Symplectomorphism/bioreactor/README.md

# ISS-Bioreactor
Some of the code for Boise State's ISS-bioreactor project.
