Symplectomorphism/bioreactor/resources/resources.md

[Teensy-SineWaveGenerator](https://github.com/jameskeaveney/Teensy-SineWaveGenerator)  
[Adafruit-SineWave](https://github.com/adafruit/Adafruit_MCP4725)
