Symplectomorphism/bioreactor/TeX/root.pdf

### Design of the Signal Generator for ISS-Bioreactor

Aykut C. Satici∗
Boise State University
Mechanical and Biomedical Engineering (Dated: April 17, 2023)
This technical report is prepared to document the design of the signal generator circuit for the ISS-Bioreactor project at Boise State University.

### 1. INTRODUCTION

We design an input PWM filter to create the desired 0−10V sine wave at 90Hz that the controller expects from a carrier PWM signal at a carrier frequency 36.6kHz. This technical report builds the final design up over a few major steps. For the impatient reader, the theoretical analysis, the implementation, and the full blown-up schematic of the final design are provided in Section 2.3, Section 3, and Figure 9 of the Appendix A, respectively.

### 2. THEORETICAL ANALYSIS

We perform a basic PWM filter design to generate the driving 0−10V sine wave signal to be fed into the Physik Instrumente (PI)’s controller for one of their piezoelectric actuators [2].

### 2.1. Basic Lowpass Filter Design

Consider the first-order filter sketched in Figure 1 with a sinusoidal driving voltage. The current i over the capacitor is i = C
dvo
dt

. KVL around the loop gives

RC dvo
dt

+ vo = vsig = A cos (ωt)
This differential equation has the transfer function

G(s) = 1 RCs + 1
The steady-state solution of the differential equation is obtained as

vo(t) = A |G(jω)| cos (ωt + ∠G(jω))

=

A
√
1 + ω²R²C² | cos (ωt − arctan (ωRC))
Since we do not want our signal to be attenuated by the low-pass filter, we must choose the values of R and C such that ωRC 1 or 2πRC 1/f.
Unfortunately, our actual input from the microcontroller is not a pure sine wave, rather a PWM signal. Therefore, we also need the value of 2πRC to be large so that it attenuates the high frequencies present in the

∗Electronic address: aykutsatici@boisestate.edu

vsig

R

C

vo

FIG. 1: A first-order low-pass filter circuit.

PWM signal. This requirement is difficult to achieve with just a first-order low-pass filter, leading us to design a second-order low-pass filter in the next subsections.

### 2.2. Second-Order LPF Design

A second-order filter is implemented as a linear operator from the Teensy-generated PWM voltage input vt to the voltage vi

, as presented in Figure 2. The remainder of this circuit constitutes a noninverting op-amp that amplifies the sine wave extracted from its PWM modulation from 0 − 3.3V to 0 − 10V. We analyze the circuit so as to figure out the values of the various resistances

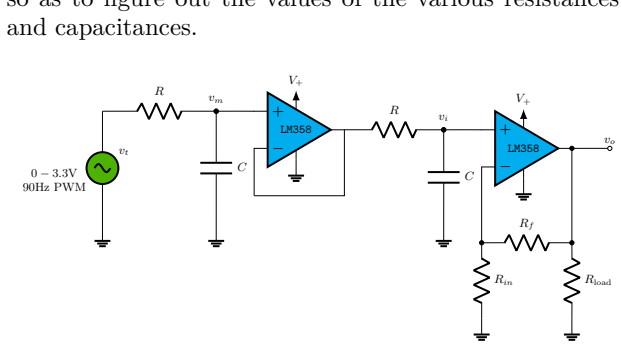
[picture p1: figure]
and capacitances.; 0 − 3.3V 90Hz PWM; Rin; Rload

FIG. 2: The signal generator circuit.

The 0−3.3V PWM signal is to be filtered to extract the modulated sine wave. Thanks to the buffer op-amp, the transfer function from the Teensy input vt to the input vi to the non-inverting amplifier op-amp is given by

H(s) = Vi(s)
Vt(s)

=

1
R²C²s

2 + 2RCs + 1

This is a critically-damped transfer function with both poles at s1,2 = −¹/RC. In other words, the cut-off frequency of this filter is at fn =
1

2πRC with a roll-off of
40dB per decade. Contrast this to the first-order filter of the previous subsection where the roll-off was 20dB per decade. The greater roll-off rate allows us be able to select 2πRC 1/f while simultaneously achieving excellent high-frequency attenuation.
Our desired signal is a 90Hz sinusoidal, which should not be attenuated by the low-pass filter, i.e., the transfer function H(s) should have approximately a unity gain at this frequency. To that end, we set fn = 5×90 = 450Hz, which produces the constraint RC ≤ 1/2πfn.
The attenuation needed at the PWM carrier frequency fc = 36.6kHz provides us with a lower bound on the product RC. If we want no less than α-fold attenuation, then we must have that

−20 log α ≥ 20 log |H(j2πfc)| = −20 log (1 + 4π

2R

2C

2
f

2
c

)

⇒ 1 + 4π

2R

2C

2
f

2
c ≥ α ⇒ RC ≥

√
α − 1
2πfc
We summarize the lower and upper bounds on RC:
√
α − 1
2πfc

≤ RC ≤

1
2πfn
Lastly, we want to amplify the input voltage vi thrice in order to hit the 0 − 10V mark. The gain of the non-inverting amplifier is k = 1 + Rf/Rin. We choose Rf , Rin ≥ 1kΩ so as to achieve k = 3. The high gain bandwidth product of the LM358 op-amp is read from its datasheet to be GBP = 1.2MHz. Hence the transfer function from the input voltage vi to the output voltage vo that will be applied to the PI controller is approximately given by

Vo(s)
Vi(s)

=

k

k
2πGBP s + 1

≈

3
3.979 × 10⁻⁷s + 1

,
which will have a firm unity gain at our desired oscillation frequency of 90Hz.

### 2.3. Sallen-Key Architecture

Another well-known architecture that works well for this sort of problem is the Sallen-Key low-pass filter, which replaces the two RC+buffer combination whose output enters the amplifier op-amp, as shown in Figure 3. The blown-up full schematic of signal generator circuit may be found in Figure 9 of the appendix.
We find the governing equations of this circuit. Assume an ideal op-amp model so that both of the inputs of the op-amp have potential vi

. Let the current i flowing over R1 split into i1 and i2, the former flowing into C1 and the latter into C2 through R2. KCL gives

i = i1 + i2 =

1
R1

(vt − vm),

i1 = C1

d(vm − vi)
dt

,

i2 = C2

dvi
dt

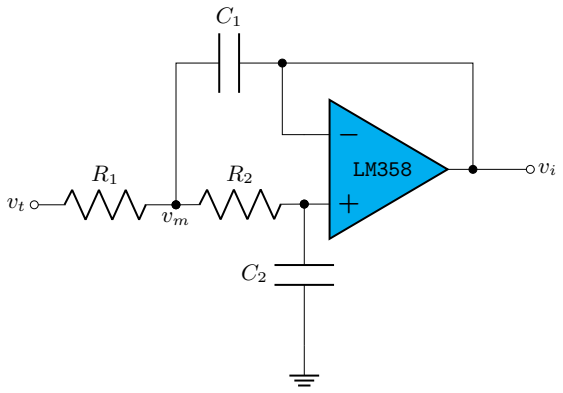
[picture p2: figure]

FIG. 3: Sallen Key (second-order) low-pass filter.

KVL around the bottom loop (vm −vi −gnd) gives vm =
R2i2 + vi = R2C2

dvi
dt + vi

. Plugging this into the second equation gives i1 = R2C1C2
d

2
vi
dt

2 . Combined with the
first and third equations, this yields

R1R2C1C2vï + (R1 + R2)C2v˙i + vi = vt. (1)
The transfer function of the Sallen-Key filter is read as
T(s) = | 1
R1R2C1C2s

2 + (R1 + R2)C2s + 1

. (2)

The gain and phase of this transfer function may be computed as follows

|T(jω)| =

1
p
1 + R²

1R²

2C²

1C²
2ω⁴

,

∠T(jω) = − arctan

(R1 + R2)C2ω
1 − R1R2C1C2ω²

(3)

We want to make this a Butterworth filter, making its frequency response as flat as possible in the passband. To that end, we identify the characteristic polynomial as

s

2 +

R1 + R2
R1R2C2

s +

1
R1R2C1C2

= s

2 + 2ζωns + ω

2
n

,
with the damping coefficient ζ = 1/
√
2. This requirement
on the damping coefficient translates to the constraint on the circuit elements:

(R1 + R2)

2
2R1R2

=

C1
C2
. | (4)

This Butterworth filter requirement simplifies the gain and phase (3) of the transfer function (2) as

|T(jω)| =

1
p
1 + 1/4(R1 + R2)

4C⁴
2ω⁴

,

∠T(jω) = − arctan

2(R1 + R2)C2ω
2 − (R1 + R2)

2C²
2ω²

(5)

We ask that the magnitude of the output signal to be very close to the input signal, i.e., 1/α1 |vt(t)| ≤ |vi(t)| ≤ |vt(t)| at the frequency of operation fo (e.g. 90Hz), where α1 > 1 and α1 ≈ 1 (e.g. α1 = 1 + 1/1000).
q
1 + 1/4(R1 + R2)

4C⁴
2

(2πfo)

4 ≤ α1,
or solving for the circuit elements

(R1 + R2)C2 ≤

p4 α
2
1 − 1
√
2πfo
. | (6)

Asking for no less than α2-fold attenuation (α2 1) at the PWM carrier frequency fc provides the constraint
q
1 + 1/4(R1 + R2)

4C⁴
2

(2πfc)

4 ≥ α2,
or, solving for the circuit elements,

(R1 + R2)C2 ≥

p4 α
2
2 − 1
√
2πfc
. | (7)

Combining the gain requirements (6) and (7), we obtain the design interval

p4 α
2
2 − 1
√
2πfc

≤ (R1 + R2)C2 ≤

p4 α
2
1 − 1
√
2πfo

. (8)

To find specific values for the resistances and capacitances, we specify the following quantities:
1. Tolerated attenuation at operation frequency: α1,
2. The value of the decoupling capacitance: C2,
3. The ratio between the resistances: r = R1/R2. Once these are specified, the values of the remaining circuit components can be pinpointed. Indeed, from the constraint (4), we obtain that

C1 =

(1 + r)

2
2r

C2.
We make sure that the signal amplitude is attenuated no more than a factor of α1 at the operating frequency as well as provides ample attenuation at the PWM carrier frequency by satisfying the second inequality in (8) as equality. This gives

R2 =

p4 α
2
1 − 1
(1 + r)

√
2πC2

and R1 = rR2.

Remark 1. Choosing the values for the circuit elements in this manner also determines the natural frequency and hence the phase shift. From the Sallen-Key filter transfer function 2, the natural frequency is computed from

fn =

1
2π

√
R1R2C1C2

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
1 − 1.
Further, using equation (5), the phase shift is given by

∠T(j2πf) = − arctan

√
2f/fn
1 − f

/f
n

TABLE I: Theoretical values of resistances and capacitances.

R1 | R2 | C1 | C2 | Rf | Rin

440.8kΩ 88.2kΩ 3.6nF 1nF 2kΩ 1kΩ
We have used this procedure to compute the values for the circuit components, selecting α1 = 1 + 1/1000, C2 = 1nF and r = 5. The values for the remaining components are provided in Table I. This is a Butterworth filter that is maximally flat in its passband with fn = 425.5Hz and provides −77.4dB attenuation at the carrier frequency. At the operation frequency fo = 90Hz, this filter introduces a phase shift of −17.39◦
Remark 2. This is the filter to be implemented in the final design. The experimental values of R1, R2, C1 and C2 are selected to be standard values that are closest to the values provided in Table I.

### 3. RESULTS

We provide extensive simulation and experimental data and their interpretation, supporting that the proposed analog signal generator works as intended.

### 3.1. Simulation

We perform a realistic LTSpice [1] simulation of both second-order filters derived in Sections (2.2, 2.3). One of the important aspects of these designs is the selection of the op-amp. In order to keep the common-mode voltage at 0V we choose the op-amps as CMOS type. One such op-amp is LM358 [4], which is used in the final design, even though a similar op-amp OP292 was used in this simulation.
The PWM signal generated by Teensy [3] is simulated with a carrier frequency of 36.6kHz modulating the signal

Vpwm = 3.3/2 + 3.3/2 sin (2π90t).
Finally, the impedance of the load (PI’s controller) is read off from its datasheet and inserted as a 100kΩ resistance.
3.1.1. RC+Buffer Simulation The simulation for the architecture in Section 2.2 generates the relevant voltage responses, provided in Figure 5. The top plot shows the PWM signal generated by Teensy modulating a sine-wave at 90Hz frequency. The individual plots in the middle show the output of the first (green) and the second (purple) RC low-pass filters (vm and vi

in Figure 2, respectively) that extract the modulated signal from its PWM representation. Finally, the last plot shows the thrice amplified signal through the op-amp OP292. The simulated circuit is provided in Figure 4.

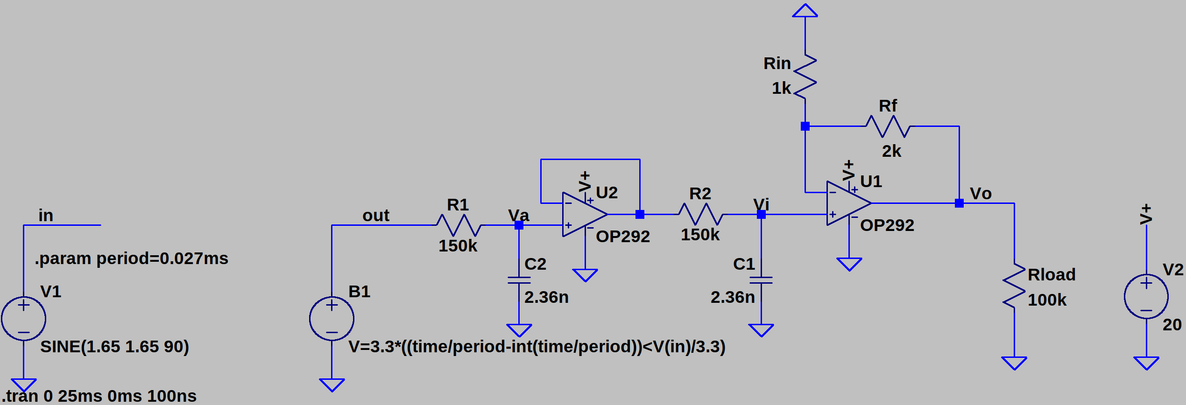
[picture p3: figure]

FIG. 4: The RC+buffer signal generator circuit in LTSpice.

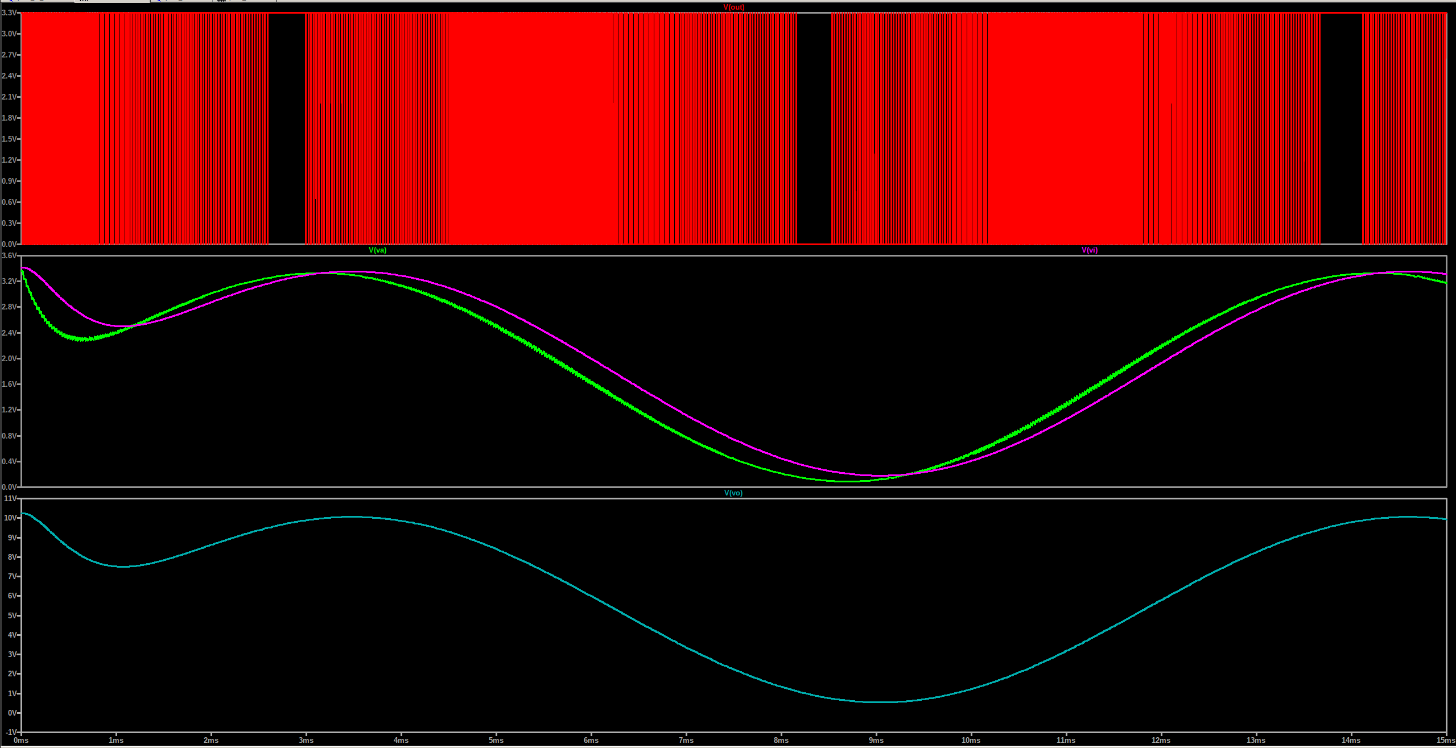
[picture p4: figure]

FIG. 5: The response of the RC+buffer signal generator.

3.1.2. Sallen-Key Simulation The performance of the Sallen-Key architecture from Section 2.3 is shown in Figure 6. The values for the resistances were taken to be R1 = 416.8kΩ, R2 = 83.4kΩ, Rf = 2Rin = 1kΩ and capacitances to be C1 = 3.6nF, C2 = 1nF. The LTSpice circuit diagram for this simulation is provided in Figure 7. Even though the performance of the Sallen-Key filter of Section 2.3 looks very similar to the RC+buffer filter of Secton 2.2 in simulation, the experiments favor the Sallen-Key significantly. We will implement this filter in our final design.

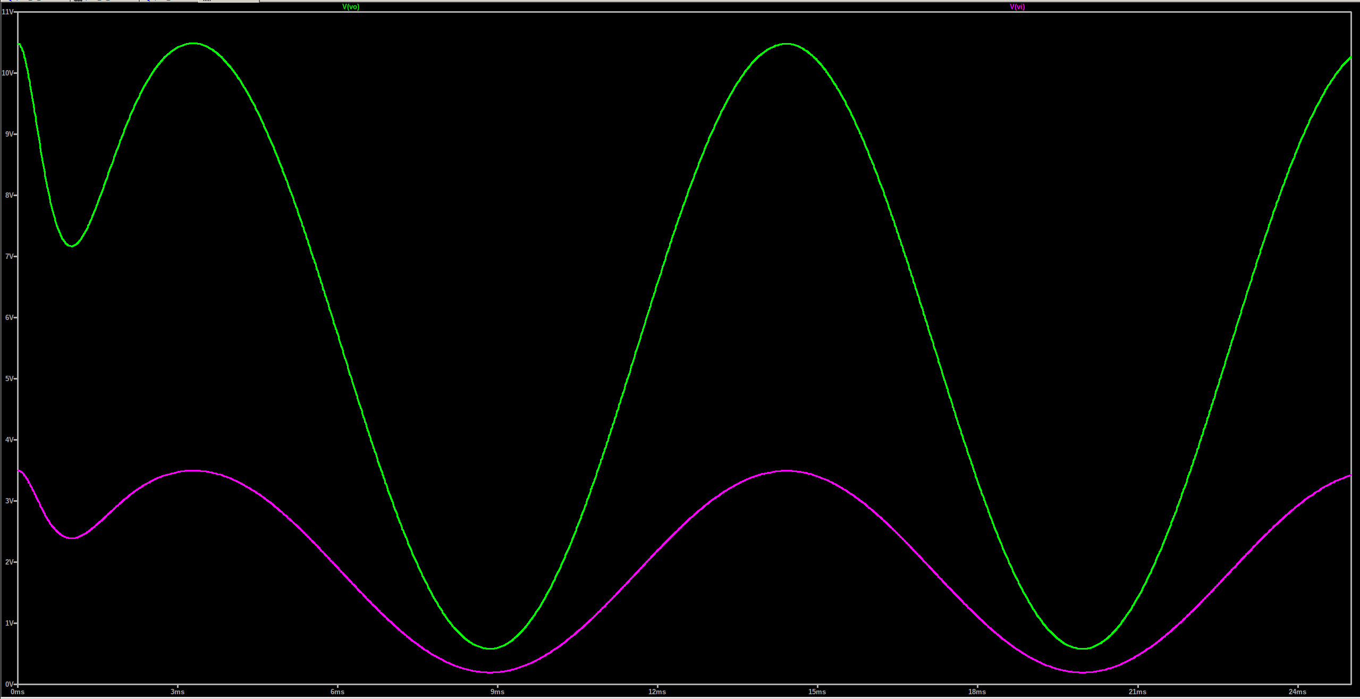
[picture p5: figure]

FIG. 6: The response of the Sallen-Key architecture.

### 3.2. Experiment

The Sallen-Key architecture is implemented on a simple setup on my tabletop. A snapshot of Teensy’s PWM signal that modulates the desired sine-wave output is provided in Figure 8a.

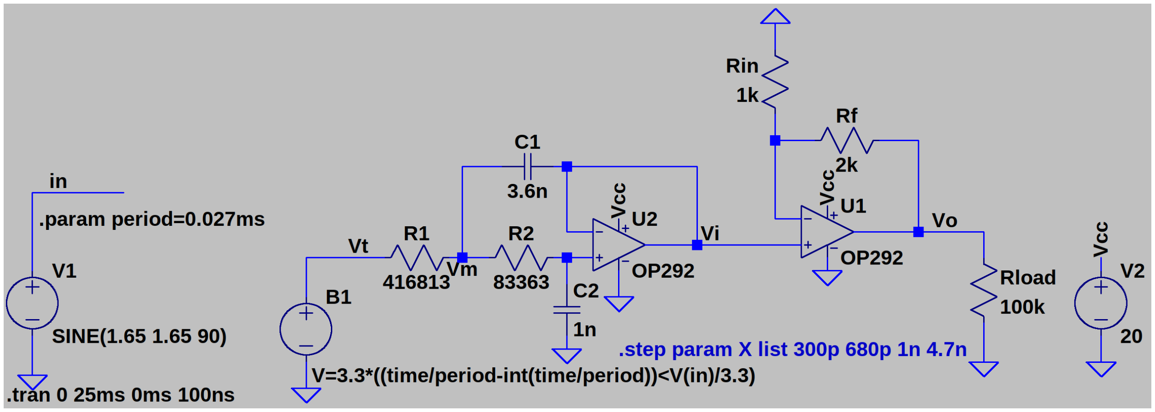
[picture p6: figure]

FIG. 7: The Sallen-Key filter circuit in LTSpice.

Figure 8b shows the response of the second-order Sallen-Key LPF observed through an oscilloscope. This is the output of the signal generator in response to the Teensy generated 90Hz 0−3.3V PWM signal modulating the desired sine wave. This response is satisfactory and should drive the PI controller without any issues.

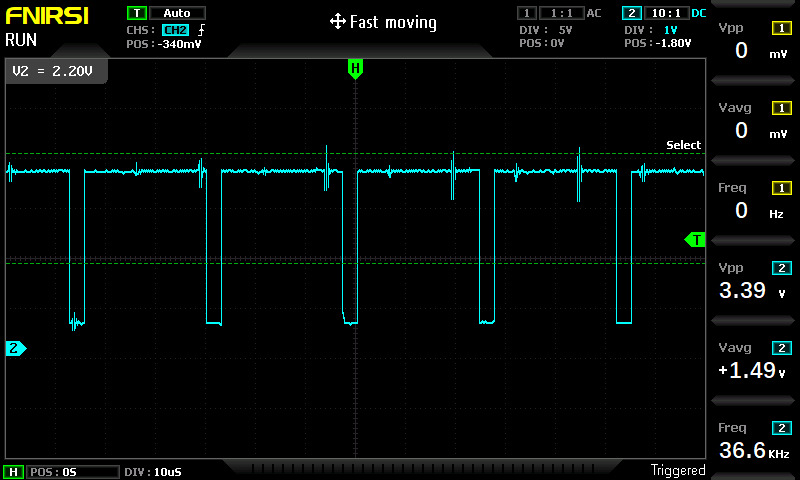
[picture p7: figure]

(a) A snapshot of Teensy’s PWM signal with a carrier frequency of
36.6kHz.

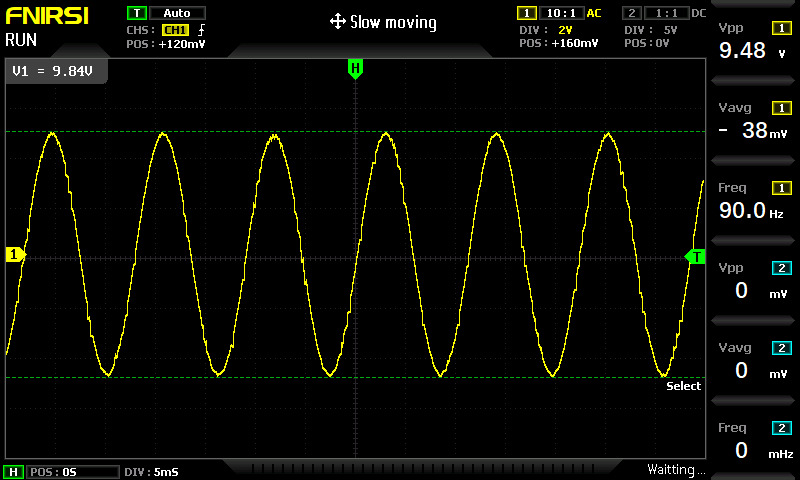
[picture p8: figure]

(b) The response of the second-order Sallen-Key filter. FIG. 8: Experimental verification of the Sallen-Key filter design.

We have also tested the signal generator by driving PI’s piezoelectric actuator. It turns out that since Teensy’s imperfect PWM generation, the best values of the various capacitances and resistances seen in the circuit diagram 9 are as given in Table II. These are the values to be used

TABLE II: Experimental values of resistances and capacitances.

R1 | R2 | C1 | C2 | Rf | Rin

500kΩ 100kΩ 3.20nF 1nF 2kΩ 1kΩ
in the final design.

### 4. DISCUSSION AND CONCLUSIONS

A sine wave is modulated using a 0−3.3V PWM output of a Teensy 4.1 microcontroller at a carrier frequency of 36.6kHz. We presented two second-order lowpass filters to extract the modulated signal from its PWM representation: (i) RC+buffer configuration, (ii) Sallen-Key architecture. We have shown that in simulation both filters perform similarly, however in experiments the Sallen-Key filter performs significantly better. We have decided to use this filter in our final design on the bioreactor.

### 5. ACKNOWLEDGMENT

The author thanks Drs. John Chiasson and Vishal Saxena of Electrical and Computer Engineering at Boise State University and University of Delaware, respectively, for their invaluable insights into the practical implementation of the signal generator.

[1] Analog Devices. | LTSpice. | URL https:
//www.analog.com/en/design-center/ design-tools-and-calculators/ltspice-simulator. html. (https://www.analog.com/en/design-center/design-tools-and-calculators/ltspice-simulator.html)
[2] Physik | Instrumente. | E-610. | URL
https://www.physikinstrumente.com/en/products/controllers-and-drivers/nanopositioning-piezo-controllers/e-610-piezo-amplifier-controller-601000. (https://www.physikinstrumente.com/en/products/controllers-and-drivers/nanopositioning-piezo-controllers/e-610-piezo-amplifier-controller-601000)
[3] PJRC. Teensy. URL https://www.pjrc.com/teensy/.
[4] Texas Instruments. LM358B. URL https://www.ti.com/product/LM358B. (https://www.ti.com/product/LM358B)

Appendix A: Full Circuit Drawing of the Final
| Design
The final signal generator circuit schematic is presented in Figure 9. The potential vt denotes the 0−3.3V PWM signal modulating a 90Hz sinusoidal wave at a carrier frequency of 36.6kHz. The potential vo denotes the 0−10V analog 90Hz sine-wave signal ready to be sent to the Physik Instrumente controller E-610, depicted in the figure as the impedance Rload, as its reference input. The capacitances and the resistances are provided in Table II.

Appendix B: Alternative Filter During testing, I have mistakenly implemented the circuit presented in Figure 10. Later, I analyzed the circuit by figuring out its transfer function. I include this circuit in here just as an academic curiosity. It has no bearing on the ISS mission and should be ignored for that purpose.

### 1. Deriving the equations of the circuit

The voltage divider at the inverting input of the second op-amp gives

vo = (1 + Rf/Rin) vi =: kvi

| | . | (B1)
Let i1 and i2 be the currents that flow over C1 and C2, respectively. KVL around various loops give the following

relationships

vm = R2i2 + vi

, | | (vm − vi − gnd), (B2)

vm = Ri1 + v1 + vi

, | (vm − v1 − vi − gnd), (B3)
vt = R1(i1 + i2) + vm, | | (vt − vm − gnd). (B4)
The constitutive equations for capacitors provide the last two relevant equations
i1 = C1v˙1, | | i2 = C2v˙i .
We want to obtain an input-output relationship between vt and vo.
a. Step 1. Use constitutive equations for the capacitors to reduce equations (B2-B4).

vm = R2C2v˙i + vi = RC1v˙1 + v1 + vi
,
vt = R1C1v˙1 + R1C2v˙i + vm.
b. Step 2. Substitute equation (B2) into equation (B4).

vt = R1C1v˙1 + R1C2v˙i + R2C2v˙i + vi
= R1C1v˙1 + (R1 + R2)C2v˙i + vi .
c. Step 3. Eliminate v1 and v˙1.

RC1vṫ + vt = R1C1 (RC1v¨1 + ˙v1) + (R1 + R2)RC1C2vï+ RC1v˙i + (R1 + R2)C2v˙i + vi
= R1R2C1C2vï + (R1 + R2)RC1C2vï+ (RC1 + (R1 + R2)C2) ˙vi + vi
= (R1R2 + R1R + R2R) C1C2
| | {z | }
| a

vï+

(RC1 + (R1 + R2)C2)
| | {z | }
| b | v˙i + vi

where in the second equality, we used the first equations from Step 1. Combining this with equation (B1) we obtain the final relationship.

avö + bvȯ + vo = k(RC1vṫ + vt). | (B5)

As a transfer function, we have

T(s) = Vo(s)
Vt(s)

= k

RC1s + 1
as² + bs + 1

. (B6)

Note that if R = 0, we recover the original Sallen-Key low-pass filter transfer function (2):

Vo(s)
Vt(s)

=

k
R1R2C1C2s

2 + (R1 + R2)C2s + 1

### 2. Analyzing the circuit

This filter has a zero in the left-half plane at z = −¹/RC1, in contrast to the original Sallen-Key filter. The presence of the resistance R is almost always parasitic and does not help with the desired signal generation.

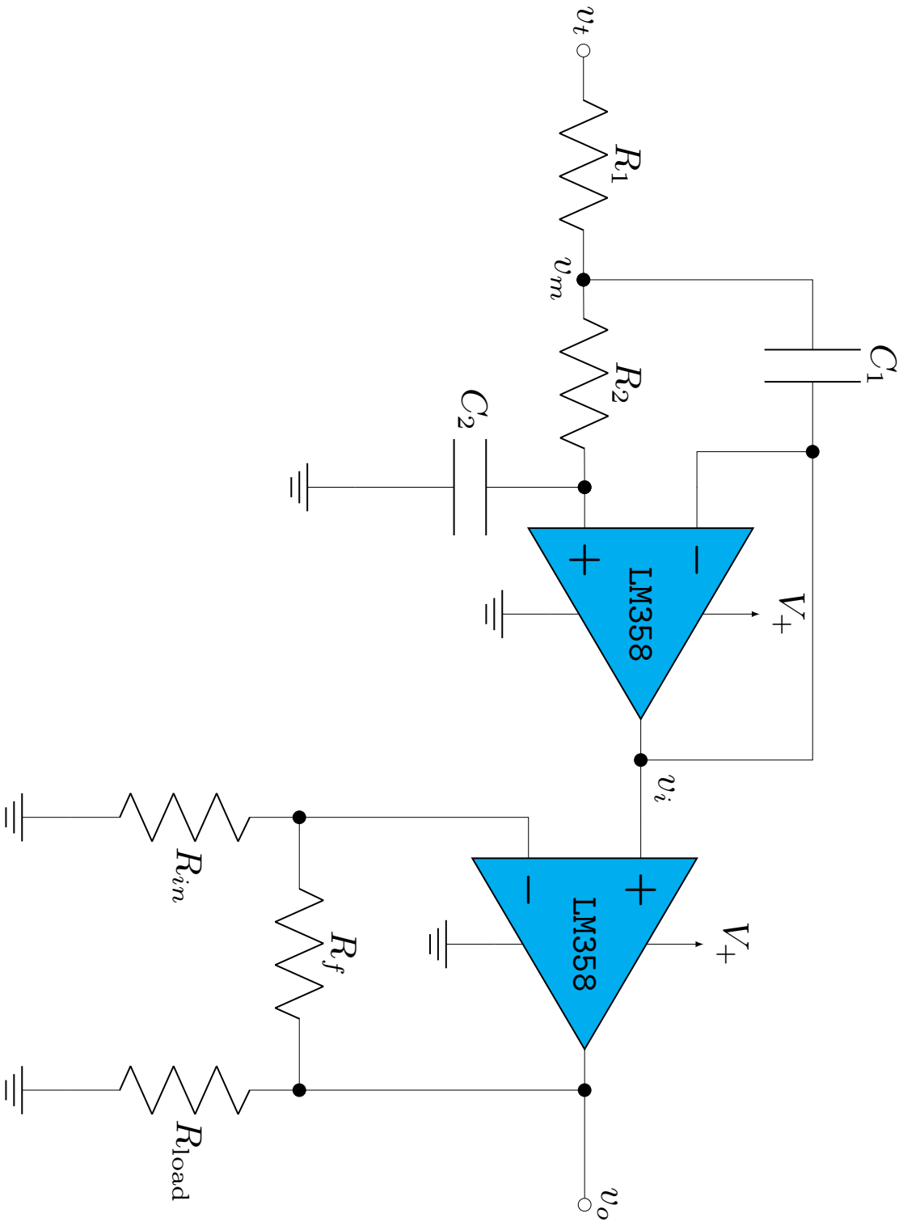
[picture p9: figure]
Rin; Rload

FIG. 9: The final signal generator circuit design.

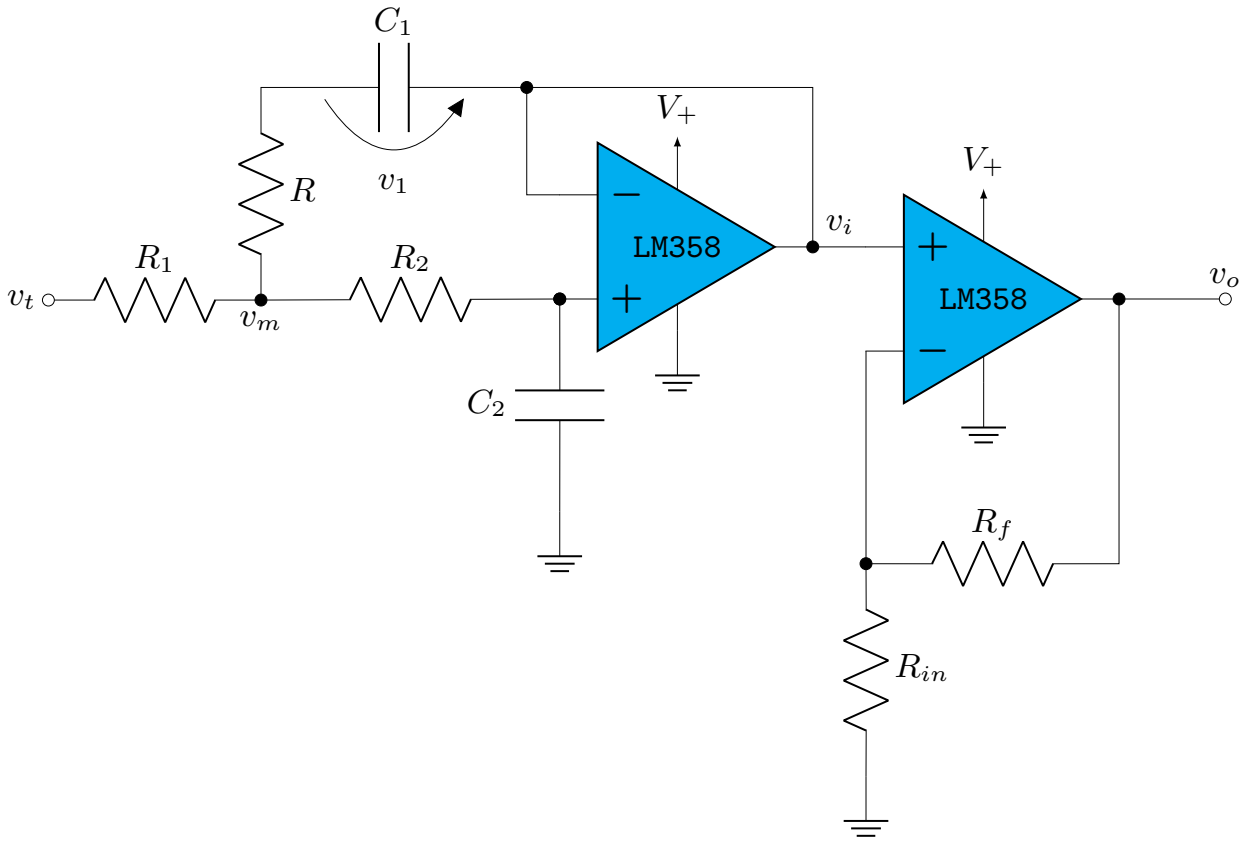
[picture p10: figure]
Rin

FIG. 10: Alternative LPF circuit.
