Symplectomorphism/bioreactor/TeX/figures/sample-fig4.pdf

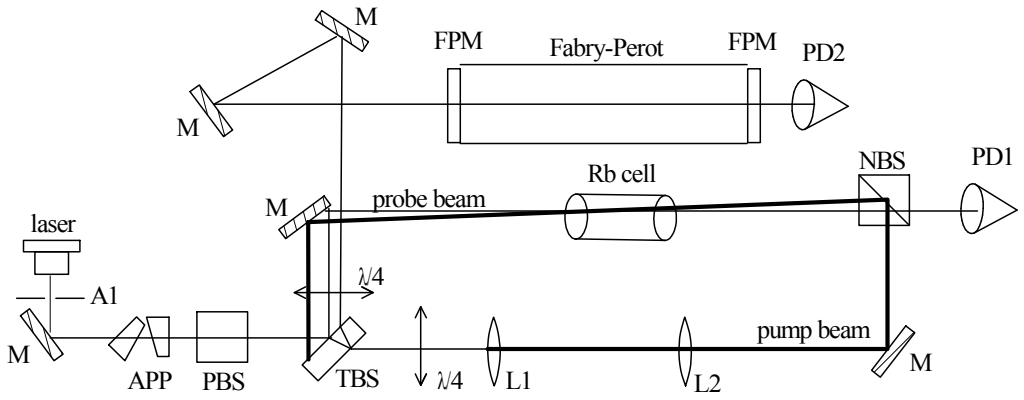
[picture p11: figure]
laser; TBS; Fabry-Perot; Rb cell; pump beam; probe beam; APP; PBS; NBS; FPM
