Symplectomorphism/bioreactor/resources/resources.pdf

Teensy-SineWaveGenerator (https://github.com/jameskeaveney/Teensy-SineWaveGenerator)
Adafruit-SineWave (https://github.com/adafruit/Adafruit_MCP4725)

1
