Symplectomorphism/bioreactor/TeX/contents/title.tex

\title{Design of the Signal Generator for ISS-Bioreactor}
\author         {Aykut C. Satici}
\email          {aykutsatici@boisestate.edu}
% \homepage{https://symplectomorphism.github.io/}
% \author         {Omor Khan}
% \email          {omorkhan@u.boisestate.edu}
% \author         {Gunes Uzer}
% \email          {gunesuzer@boisestate.edu}
\date{\today}
\affiliation{Boise State University \\ Mechanical and Biomedical Engineering}

\begin{abstract}
\noindent
This technical report is prepared to document the design of the signal generator
circuit for the ISS-Bioreactor project at Boise State University.
\end{abstract}

\maketitle

%%%%%%%%%%%%%%%%%%%%%%%%%%%%%%%%%%%%%%%%%%%%%%%%%%%%%%%%%%%%%%%%%%
