Symplectomorphism/bioreactor/simulation/figures/circuit.png

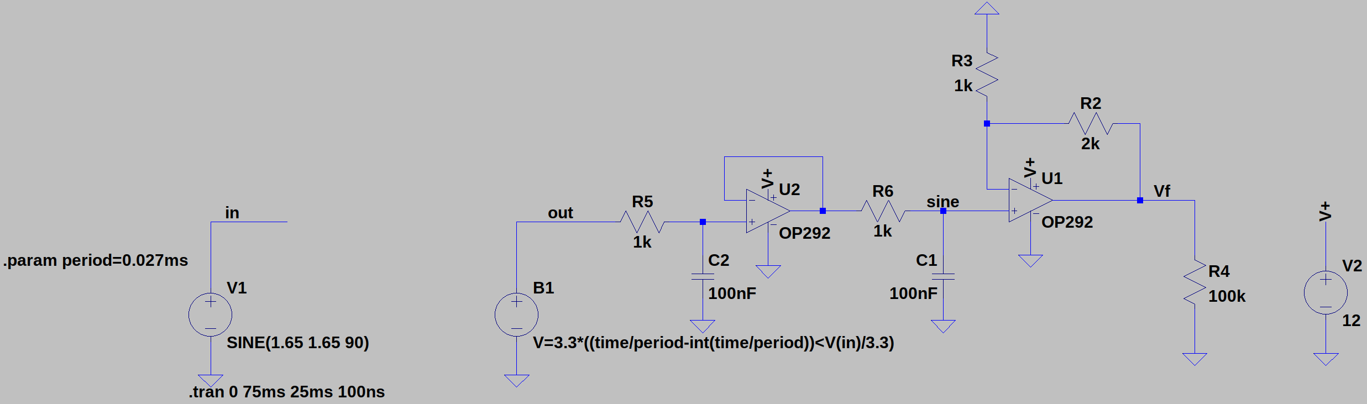
simulation/figures/circuit.png
