Symplectomorphism/bioreactor/simulation/figures/the_circuit_and_response.png

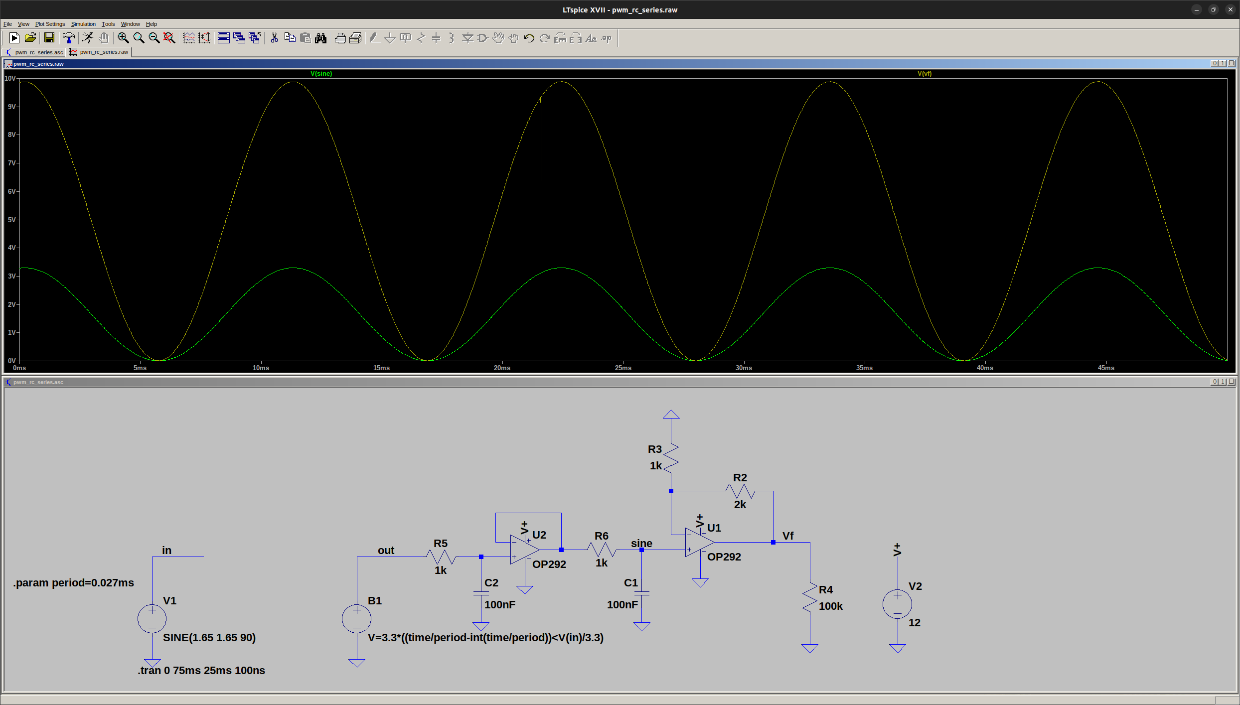
simulation/figures/the_circuit_and_response.png
