Symplectomorphism/bioreactor/TeX/figures/output_osc.bmp

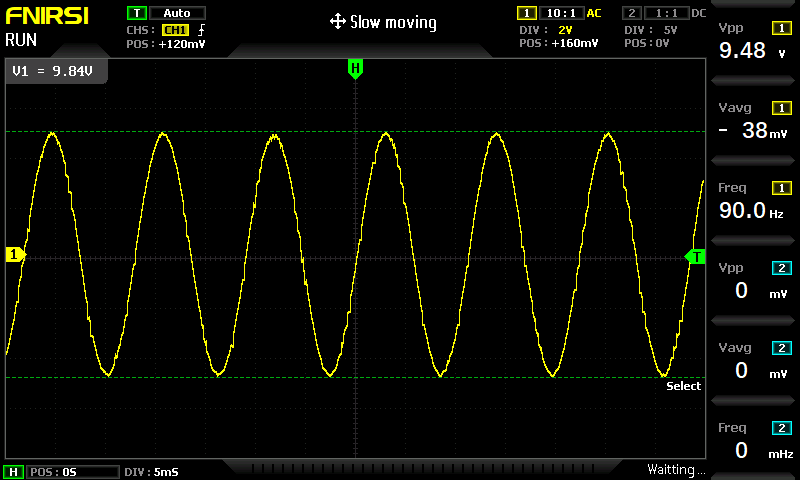
TeX/figures/output_osc.bmp
