Symplectomorphism/bioreactor/TeX/figures/prototype.jpg

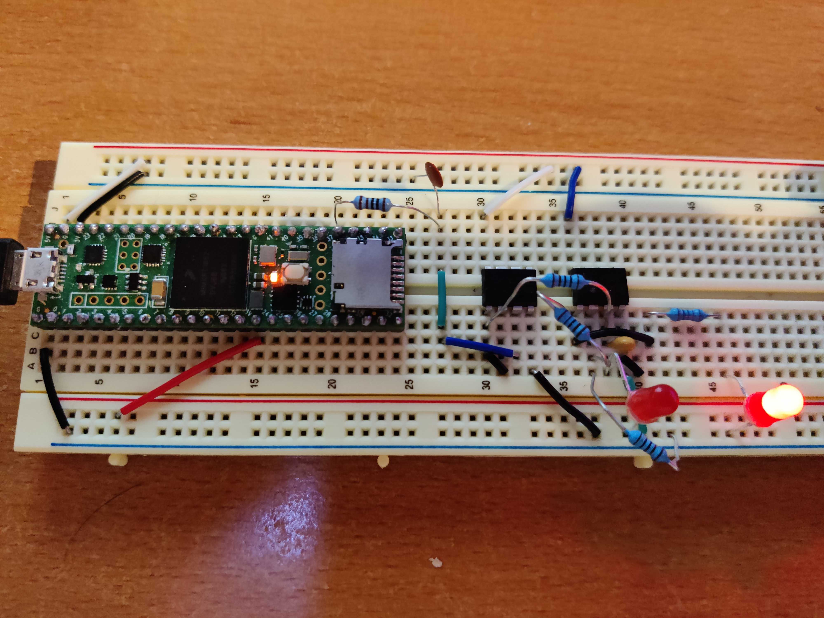
TeX/figures/prototype.jpg
