Symplectomorphism/bioreactor/TeX/figures/sallenkey.png

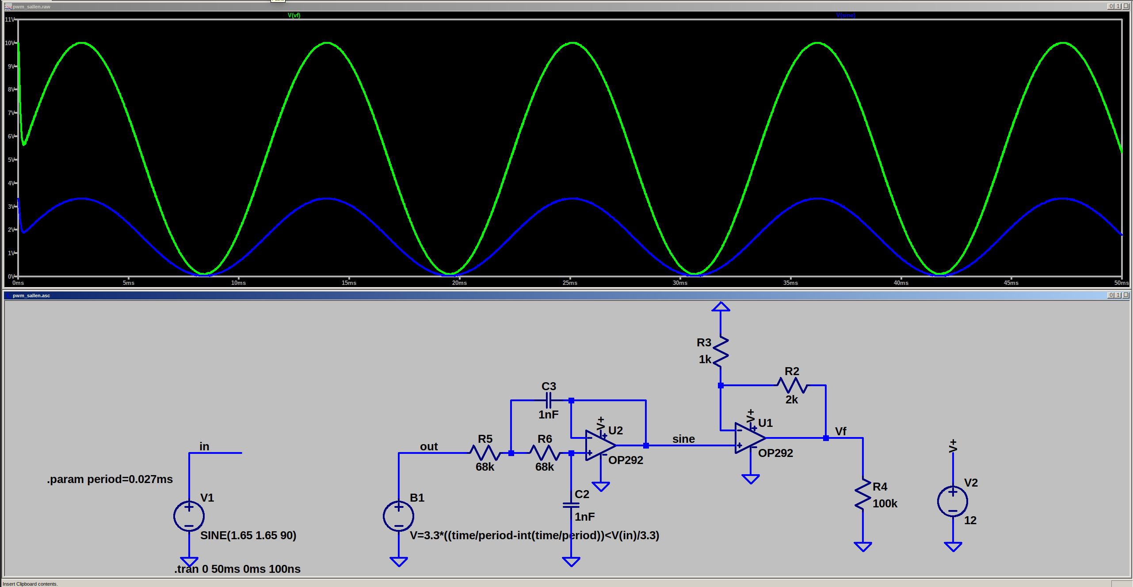
TeX/figures/sallenkey.png
