Symplectomorphism/bioreactor/simulation/pwm_sallen.asc

B1: bv; V=3.3*((time/period-int(time/period))<V(in)/3.3)
C2: cap; {X}
C3: cap; {X}
R2: res; 2k
R3: res; 1k
R4: res; 100k
R5: res; 100k
R6: res; 100k
U1: OP292
U2: OP292
V1: voltage; SINE(1.65 1.65 90)
V2: voltage; 11
Named nets: 0, in, out, sine, V+, Vf
.tran 0 25ms 0ms 100ns
.param period=0.027ms
.step param X list 300p 680p 1n 4.7n
