Symplectomorphism/bioreactor/simulation/pwm_rc_series.asc

B1: bv; V=3.3*((time/period-int(time/period))<V(in)/3.3)
C1: cap; 100nF
C2: cap; 100nF
R1: res; 2k
R3: res; 1k
R4: res; 100k
R5: res; 1k
R6: res; 1k
U1: OP292
U2: OP292
V1: voltage; SINE(1.65 1.65 90)
V2: voltage; 11
Named nets: 0, in, out, sine, V+, Vf
.tran 0 50ms 0ms 100ns
.param period=0.027ms
