Symplectomorphism/bioreactor/simulation/pwm.asc

B1: bv; V=3.3*((time/period-int(time/period))<V(in)/3.3)
C1: cap; 100nF
R1: res; 2k
R2: res; 2k
R3: res; 1k
R4: res; 100k
U1: OP292
V1: voltage; SINE(1.65 1.65 90)
V2: voltage; 12
Named nets: 0, in, out, sine, V+, Vf
.tran 0 150ms 100ms 100ns
.param period=0.027ms
