Symplectomorphism/bioreactor/(commit log)

2023-04-06 set PWM write frequency to maximum
2023-04-07 use tikz to draw the real circuit
2023-04-07 circuit in
2023-04-08 Currently in working condition!
2023-04-09 added Teensy's pwm into the tech report
2023-04-10 capacitor value sweep simulation
